steveandkureen/SprinklerMaster/content/setup.html

# SprinklerMaster

WiFi Setup

WiFi Network (SSID) Password Save & Reboot
