steveandkureen/SprinklerMaster/lwipopts.h

#ifndef _LWIPOPTS_H
#define _LWIPOPTS_H

// lwIP configuration for Pico W with bare-metal super loop (NO_SYS mode)
// (see https://www.nongnu.org/lwip/2_1_x/group__lwip__opts.html)

// Bare-metal mode (NO_SYS = 1)
#define NO_SYS 1
#define LWIP_SOCKET 0
#define LWIP_NETCONN 0

// Memory settings
#define MEM_LIBC_MALLOC 0
#define MEM_ALIGNMENT 4
#define MEM_SIZE 32768
#define MEMP_NUM_TCP_SEG 32
#define MEMP_NUM_ARP_QUEUE 10
#define PBUF_POOL_SIZE 24
#define MEMP_NUM_SYS_TIMEOUT 16

// Protocol settings
#define LWIP_ARP 1
#define LWIP_ETHERNET 1
#define LWIP_ICMP 1
#define LWIP_RAW 1
#define LWIP_DHCP 1
#define LWIP_IPV4 1
#define LWIP_TCP 1
#define LWIP_UDP 1
#define LWIP_DNS 1
#define LWIP_TCP_KEEPALIVE 1
#define LWIP_IGMP 1
#define LWIP_MDNS_RESPONDER 1
#define LWIP_NUM_NETIF_CLIENT_DATA 1

// TCP settings
#define TCP_WND (8 * TCP_MSS)
#define TCP_MSS 1460
#define TCP_SND_BUF (8 * TCP_MSS)
#define TCP_SND_QUEUELEN ((4 * (TCP_SND_BUF) + (TCP_MSS - 1)) / (TCP_MSS))

// Interface settings
#define LWIP_NETIF_STATUS_CALLBACK 1
#define LWIP_NETIF_LINK_CALLBACK 1
#define LWIP_NETIF_HOSTNAME 1
#define LWIP_NETIF_TX_SINGLE_PBUF 1

// Checksum and optimization
#define LWIP_CHKSUM_ALGORITHM 3
#define DHCP_DOES_ARP_CHECK 0
#define LWIP_DHCP_DOES_ACD_CHECK 0
#define LWIP_IP_FORWARD 0

// NO_SYS mode does not require thread settings
#define LWIP_TIMEVAL_PRIVATE 0

// Stats settings
#define MEM_STATS 0
#define SYS_STATS 0
#define MEMP_STATS 0
#define LINK_STATS 0

// Debug settings (disabled for release)
#ifndef NDEBUG
#define LWIP_DEBUG 1
#define LWIP_STATS 1
#define LWIP_STATS_DISPLAY 1
#endif

#define ETHARP_DEBUG LWIP_DBG_OFF
#define NETIF_DEBUG LWIP_DBG_OFF
#define PBUF_DEBUG LWIP_DBG_OFF
#define API_LIB_DEBUG LWIP_DBG_OFF
#define API_MSG_DEBUG LWIP_DBG_OFF
#define SOCKETS_DEBUG LWIP_DBG_OFF
#define ICMP_DEBUG LWIP_DBG_OFF
#define INET_DEBUG LWIP_DBG_OFF
#define IP_DEBUG LWIP_DBG_OFF
#define IP_REASS_DEBUG LWIP_DBG_OFF
#define RAW_DEBUG LWIP_DBG_OFF
#define MEM_DEBUG LWIP_DBG_OFF
#define MEMP_DEBUG LWIP_DBG_OFF
#define SYS_DEBUG LWIP_DBG_OFF
#define TCP_DEBUG LWIP_DBG_OFF
#define TCP_INPUT_DEBUG LWIP_DBG_OFF
#define TCP_OUTPUT_DEBUG LWIP_DBG_OFF
#define TCP_RTO_DEBUG LWIP_DBG_OFF
#define TCP_CWND_DEBUG LWIP_DBG_OFF
#define TCP_WND_DEBUG LWIP_DBG_OFF
#define TCP_FR_DEBUG LWIP_DBG_OFF
#define TCP_QLEN_DEBUG LWIP_DBG_OFF
#define TCP_RST_DEBUG LWIP_DBG_OFF
#define UDP_DEBUG LWIP_DBG_OFF
#define TCPIP_DEBUG LWIP_DBG_OFF
#define PPP_DEBUG LWIP_DBG_OFF
#define SLIP_DEBUG LWIP_DBG_OFF
#define DHCP_DEBUG LWIP_DBG_OFF

#define LWIP_HTTPD_CGI 1
#define LWIP_HTTPD_SSI 1
#define LWIP_HTTPD_SSI_INCLUDE_TAG 0
#define LWIP_HTTPD_SSI_EXTENSIONS ".shtml", ".shtm", ".ssi", ".xml", ".json", ".html"
#define LWIP_HTTPD_MAX_TAG_INSERT_LEN 4096  // Increased for schedule + program + history JSON output
#define HTTPD_FSDATA_FILE "pico_fsdata.inc"

// SNTP (NTP time sync) settings
#define LWIP_SNTP 1
#define SNTP_SERVER_DNS 1
#define SNTP_MAX_SERVERS 2
#define SNTP_UPDATE_DELAY 3600000  // Update every hour (in ms)

// Set system time when NTP response is received (routes through DS3231 sync)
#include <sys/time.h>
extern void ds3231_sync_from_ntp(uint32_t ntp_seconds);
#define SNTP_SET_SYSTEM_TIME(sec) ds3231_sync_from_ntp(sec)

#endif
