steveandkureen/SprinklerMaster/wifi_credentials_template.h

#ifndef WIFI_CREDENTIALS_H
#define WIFI_CREDENTIALS_H

// WiFi Credentials Template
// Copy this file to wifi_credentials.h and update with your actual credentials
// wifi_credentials.h is in .gitignore and won't be committed

#define WIFI_SSID "YOUR_WIFI_SSID"
#define WIFI_PASSWORD "YOUR_WIFI_PASSWORD"

#endif // WIFI_CREDENTIALS_H
