steveandkureen/SprinklerMaster/(commit log)

2026-02-02 added watchdog to auto restart when a problem is detected
    [config_flash.c, config_flash.h, fault_tolerance.c, fault_tolerance.h, lcd.c, lcd_display.c, lcd_display.h, network.c]
2026-02-13 adding battery backup clock
2026-02-21 adding program but not working yet
    [config_flash.c, config_flash.h, lwipopts.h, network.c, network.h, scheduler.c, scheduler.h]
2026-02-26 cleanup to get rid of freertos after switching to super loop
